adulu-bang/chipathon-2026-gf180mcu-padring/signoff_reports/metrics.csv

Metric | Value
design__lint_error__count | 0
design__lint_timing_construct__count | 0
design__lint_warning__count | 1
design__inferred_latch__count | 0
design__instance__count | 5316
design__instance__area | 257479
design__instance_unmapped__count | 0
synthesis__check_error__count | 0
design__max_slew_violation__count__corner:nom_tt_025C_5v00 | 0
design__max_fanout_violation__count__corner:nom_tt_025C_5v00 | 0
design__max_cap_violation__count__corner:nom_tt_025C_5v00 | 0
power__internal__total | 0.0000039727974581182934
power__switching__total | 0.000004177526534476783
power__leakage__total | 3.2316324904968496E-7
power__total | 0.000008473487469018437
clock__skew__worst_hold__corner:nom_tt_025C_5v00 | 0.0
clock__skew__worst_setup__corner:nom_tt_025C_5v00 | 0.0
timing__hold__ws__corner:nom_tt_025C_5v00 | 21.90605980838216
timing__setup__ws__corner:nom_tt_025C_5v00 | 55.73807884115806
timing__hold__tns__corner:nom_tt_025C_5v00 | 0.0
timing__setup__tns__corner:nom_tt_025C_5v00 | 0.0
timing__hold__wns__corner:nom_tt_025C_5v00 | 0
timing__setup__wns__corner:nom_tt_025C_5v00 | 0.0
timing__hold_vio__count__corner:nom_tt_025C_5v00 | 0
timing__hold_r2r__ws__corner:nom_tt_025C_5v00 | Infinity
timing__hold_r2r_vio__count__corner:nom_tt_025C_5v00 | 0
timing__setup_vio__count__corner:nom_tt_025C_5v00 | 0
timing__setup_r2r__ws__corner:nom_tt_025C_5v00 | Infinity
timing__setup_r2r_vio__count__corner:nom_tt_025C_5v00 | 0
design__max_slew_violation__count__corner:nom_ss_125C_4v50 | 0
design__max_fanout_violation__count__corner:nom_ss_125C_4v50 | 0
design__max_cap_violation__count__corner:nom_ss_125C_4v50 | 0
clock__skew__worst_hold__corner:nom_ss_125C_4v50 | 0.0
clock__skew__worst_setup__corner:nom_ss_125C_4v50 | 0.0
timing__hold__ws__corner:nom_ss_125C_4v50 | 23.881338471593665
timing__setup__ws__corner:nom_ss_125C_4v50 | 52.35916737267601
timing__hold__tns__corner:nom_ss_125C_4v50 | 0.0
timing__setup__tns__corner:nom_ss_125C_4v50 | 0.0
timing__hold__wns__corner:nom_ss_125C_4v50 | 0
timing__setup__wns__corner:nom_ss_125C_4v50 | 0.0
timing__hold_vio__count__corner:nom_ss_125C_4v50 | 0
timing__hold_r2r__ws__corner:nom_ss_125C_4v50 | Infinity
timing__hold_r2r_vio__count__corner:nom_ss_125C_4v50 | 0
timing__setup_vio__count__corner:nom_ss_125C_4v50 | 0
timing__setup_r2r__ws__corner:nom_ss_125C_4v50 | Infinity
timing__setup_r2r_vio__count__corner:nom_ss_125C_4v50 | 0
design__max_slew_violation__count__corner:nom_ff_n40C_5v50 | 0
design__max_fanout_violation__count__corner:nom_ff_n40C_5v50 | 0
design__max_cap_violation__count__corner:nom_ff_n40C_5v50 | 0
clock__skew__worst_hold__corner:nom_ff_n40C_5v50 | 0.0
clock__skew__worst_setup__corner:nom_ff_n40C_5v50 | 0.0
timing__hold__ws__corner:nom_ff_n40C_5v50 | 21.042181925812898
timing__setup__ws__corner:nom_ff_n40C_5v50 | 57.26129421588221
timing__hold__tns__corner:nom_ff_n40C_5v50 | 0.0
timing__setup__tns__corner:nom_ff_n40C_5v50 | 0.0
timing__hold__wns__corner:nom_ff_n40C_5v50 | 0
timing__setup__wns__corner:nom_ff_n40C_5v50 | 0.0
timing__hold_vio__count__corner:nom_ff_n40C_5v50 | 0
timing__hold_r2r__ws__corner:nom_ff_n40C_5v50 | Infinity
timing__hold_r2r_vio__count__corner:nom_ff_n40C_5v50 | 0
timing__setup_vio__count__corner:nom_ff_n40C_5v50 | 0
timing__setup_r2r__ws__corner:nom_ff_n40C_5v50 | Infinity
timing__setup_r2r_vio__count__corner:nom_ff_n40C_5v50 | 0
design__max_slew_violation__count__corner:min_tt_025C_5v00 | 0
design__max_fanout_violation__count__corner:min_tt_025C_5v00 | 0
design__max_cap_violation__count__corner:min_tt_025C_5v00 | 0
clock__skew__worst_hold__corner:min_tt_025C_5v00 | 0.0
clock__skew__worst_setup__corner:min_tt_025C_5v00 | 0.0
timing__hold__ws__corner:min_tt_025C_5v00 | 21.876268526986024
timing__setup__ws__corner:min_tt_025C_5v00 | 55.827550384975396
timing__hold__tns__corner:min_tt_025C_5v00 | 0.0
timing__setup__tns__corner:min_tt_025C_5v00 | 0.0
timing__hold__wns__corner:min_tt_025C_5v00 | 0
timing__setup__wns__corner:min_tt_025C_5v00 | 0.0
timing__hold_vio__count__corner:min_tt_025C_5v00 | 0
timing__hold_r2r__ws__corner:min_tt_025C_5v00 | Infinity
timing__hold_r2r_vio__count__corner:min_tt_025C_5v00 | 0
timing__setup_vio__count__corner:min_tt_025C_5v00 | 0
timing__setup_r2r__ws__corner:min_tt_025C_5v00 | Infinity
timing__setup_r2r_vio__count__corner:min_tt_025C_5v00 | 0
design__max_slew_violation__count__corner:min_ss_125C_4v50 | 0
design__max_fanout_violation__count__corner:min_ss_125C_4v50 | 0
design__max_cap_violation__count__corner:min_ss_125C_4v50 | 0
clock__skew__worst_hold__corner:min_ss_125C_4v50 | 0.0
clock__skew__worst_setup__corner:min_ss_125C_4v50 | 0.0
timing__hold__ws__corner:min_ss_125C_4v50 | 23.83451548033967
timing__setup__ws__corner:min_ss_125C_4v50 | 52.508605172373784
timing__hold__tns__corner:min_ss_125C_4v50 | 0.0
timing__setup__tns__corner:min_ss_125C_4v50 | 0.0
timing__hold__wns__corner:min_ss_125C_4v50 | 0
timing__setup__wns__corner:min_ss_125C_4v50 | 0.0
timing__hold_vio__count__corner:min_ss_125C_4v50 | 0
timing__hold_r2r__ws__corner:min_ss_125C_4v50 | Infinity
timing__hold_r2r_vio__count__corner:min_ss_125C_4v50 | 0
timing__setup_vio__count__corner:min_ss_125C_4v50 | 0
timing__setup_r2r__ws__corner:min_ss_125C_4v50 | Infinity
timing__setup_r2r_vio__count__corner:min_ss_125C_4v50 | 0
design__max_slew_violation__count__corner:min_ff_n40C_5v50 | 0
design__max_fanout_violation__count__corner:min_ff_n40C_5v50 | 0
design__max_cap_violation__count__corner:min_ff_n40C_5v50 | 0
clock__skew__worst_hold__corner:min_ff_n40C_5v50 | 0.0
clock__skew__worst_setup__corner:min_ff_n40C_5v50 | 0.0
timing__hold__ws__corner:min_ff_n40C_5v50 | 21.021073476893317
timing__setup__ws__corner:min_ff_n40C_5v50 | 57.320791513543774
timing__hold__tns__corner:min_ff_n40C_5v50 | 0.0
timing__setup__tns__corner:min_ff_n40C_5v50 | 0.0
timing__hold__wns__corner:min_ff_n40C_5v50 | 0
timing__setup__wns__corner:min_ff_n40C_5v50 | 0.0
timing__hold_vio__count__corner:min_ff_n40C_5v50 | 0
timing__hold_r2r__ws__corner:min_ff_n40C_5v50 | Infinity
timing__hold_r2r_vio__count__corner:min_ff_n40C_5v50 | 0
timing__setup_vio__count__corner:min_ff_n40C_5v50 | 0
timing__setup_r2r__ws__corner:min_ff_n40C_5v50 | Infinity
timing__setup_r2r_vio__count__corner:min_ff_n40C_5v50 | 0
design__max_slew_violation__count__corner:max_tt_025C_5v00 | 0
design__max_fanout_violation__count__corner:max_tt_025C_5v00 | 0
design__max_cap_violation__count__corner:max_tt_025C_5v00 | 0
clock__skew__worst_hold__corner:max_tt_025C_5v00 | 0.0
clock__skew__worst_setup__corner:max_tt_025C_5v00 | 0.0
timing__hold__ws__corner:max_tt_025C_5v00 | 21.939949145122696
timing__setup__ws__corner:max_tt_025C_5v00 | 55.63240692250721
timing__hold__tns__corner:max_tt_025C_5v00 | 0.0
timing__setup__tns__corner:max_tt_025C_5v00 | 0.0
timing__hold__wns__corner:max_tt_025C_5v00 | 0
timing__setup__wns__corner:max_tt_025C_5v00 | 0.0
timing__hold_vio__count__corner:max_tt_025C_5v00 | 0
timing__hold_r2r__ws__corner:max_tt_025C_5v00 | Infinity
timing__hold_r2r_vio__count__corner:max_tt_025C_5v00 | 0
timing__setup_vio__count__corner:max_tt_025C_5v00 | 0
timing__setup_r2r__ws__corner:max_tt_025C_5v00 | Infinity
timing__setup_r2r_vio__count__corner:max_tt_025C_5v00 | 0
design__max_slew_violation__count__corner:max_ss_125C_4v50 | 0
design__max_fanout_violation__count__corner:max_ss_125C_4v50 | 0
design__max_cap_violation__count__corner:max_ss_125C_4v50 | 0
clock__skew__worst_hold__corner:max_ss_125C_4v50 | 0.0
clock__skew__worst_setup__corner:max_ss_125C_4v50 | 0.0
timing__hold__ws__corner:max_ss_125C_4v50 | 23.935876180819363
timing__setup__ws__corner:max_ss_125C_4v50 | 52.182657893980135
timing__hold__tns__corner:max_ss_125C_4v50 | 0.0
timing__setup__tns__corner:max_ss_125C_4v50 | 0.0
timing__hold__wns__corner:max_ss_125C_4v50 | 0
timing__setup__wns__corner:max_ss_125C_4v50 | 0.0
timing__hold_vio__count__corner:max_ss_125C_4v50 | 0
timing__hold_r2r__ws__corner:max_ss_125C_4v50 | Infinity
timing__hold_r2r_vio__count__corner:max_ss_125C_4v50 | 0
timing__setup_vio__count__corner:max_ss_125C_4v50 | 0
timing__setup_r2r__ws__corner:max_ss_125C_4v50 | Infinity
timing__setup_r2r_vio__count__corner:max_ss_125C_4v50 | 0
design__max_slew_violation__count__corner:max_ff_n40C_5v50 | 0
design__max_fanout_violation__count__corner:max_ff_n40C_5v50 | 0
design__max_cap_violation__count__corner:max_ff_n40C_5v50 | 0
clock__skew__worst_hold__corner:max_ff_n40C_5v50 | 0.0
clock__skew__worst_setup__corner:max_ff_n40C_5v50 | 0.0
timing__hold__ws__corner:max_ff_n40C_5v50 | 21.06574352359707
timing__setup__ws__corner:max_ff_n40C_5v50 | 57.19047797211986
timing__hold__tns__corner:max_ff_n40C_5v50 | 0.0
timing__setup__tns__corner:max_ff_n40C_5v50 | 0.0
timing__hold__wns__corner:max_ff_n40C_5v50 | 0
timing__setup__wns__corner:max_ff_n40C_5v50 | 0.0
timing__hold_vio__count__corner:max_ff_n40C_5v50 | 0
timing__hold_r2r__ws__corner:max_ff_n40C_5v50 | Infinity
timing__hold_r2r_vio__count__corner:max_ff_n40C_5v50 | 0
timing__setup_vio__count__corner:max_ff_n40C_5v50 | 0
timing__setup_r2r__ws__corner:max_ff_n40C_5v50 | Infinity
timing__setup_r2r_vio__count__corner:max_ff_n40C_5v50 | 0
design__max_slew_violation__count | 0
design__max_fanout_violation__count | 0
design__max_cap_violation__count | 0
clock__skew__worst_hold | 0.0
clock__skew__worst_setup | 0.0
timing__hold__ws | 21.021073476893317
timing__setup__ws | 52.182657893980135
timing__hold__tns | 0.0
timing__setup__tns | 0.0
timing__hold__wns | 0
timing__setup__wns | 0.0
timing__hold_vio__count | 0
timing__hold_r2r__ws | inf
timing__hold_r2r_vio__count | 0
timing__setup_vio__count | 0
timing__setup_r2r__ws | inf
timing__setup_r2r_vio__count | 0
design__die__bbox | 0.0 0.0 550.0 550.0
design__core__bbox | 15.12 15.68 534.8 533.12
design__io | 36
design__die__area | 302500
design__core__area | 268903
design__instance__count__stdcell | 1870
design__instance__area__stdcell | 8594.21
design__instance__count__macros | 2
design__instance__area__macros | 32600.9
design__instance__count__padcells | 0
design__instance__area__padcells | 0
design__instance__count__cover | 0
design__instance__area__cover | 0
design__instance__utilization | 0.153197
design__instance__utilization__stdcell | 0.0363695
design__rows | 179
design__rows:GF018hv5v_mcu_sc7 | 179
design__sites | 102441
design__sites:GF018hv5v_mcu_sc7 | 102441
design__instance__count__class:macro | 2
design__instance__area__class:macro | 32600.9
design__instance__count__class:tie_cell | 24
design__instance__area__class:tie_cell | 210.739
design__instance__count__class:multi_input_combinational_cell | 3
design__instance__area__class:multi_input_combinational_cell | 76.832
flow__warnings__count | 1
flow__errors__count | 0
flow__warnings__count:IFP-0028 | 1
flow__warnings__count:ODB-0220 | 3
flow__warnings__count:ORD-2011 | 1
flow__warnings__type_count | 1
flow__warnings__count:ORD-0039 | 1
design__instance__count__class:endcap_cell | 358
design__instance__area__class:endcap_cell | 1571.76
design__instance__count__class:tap_cell | 1458
design__instance__area__class:tap_cell | 6401.2
design__power_grid_violation__count__net:GND | 0
design__power_grid_violation__count__net:VDD | 0
design__power_grid_violation__count | 0
timing__drv__floating__nets | 2
timing__drv__floating__pins | 0
design__instance__displacement__total | 0
design__instance__displacement__mean | 0
design__instance__displacement__max | 0
route__wirelength__estimated | 5074.58
design__violations | 0
design__instance__count__class:timing_repair_buffer | 7
design__instance__area__class:timing_repair_buffer | 245.862
flow__warnings__count:RSZ-0020 | 1
flow__warnings__count:STA-1140 | 14
flow__warnings__count:CTS-0041 | 1
flow__warnings__count:CTS-0082 | 1
flow__warnings__count:CTS-0083 | 1
design__instance__count__setup_buffer | 0
design__instance__count__hold_buffer | 0
global_route__vias | 206
global_route__wirelength | 5636
antenna__violating__nets | 0
antenna__violating__pins | 0
route__antenna_violation__count | 0
design__instance__count__class:antenna_cell | 20
design__instance__area__class:antenna_cell | 87.808
antenna_diodes_count | 0
route__net | 46
route__net__special | 2
route__drc_errors__iter:0 | 0
route__wirelength__iter:0 | 5051
route__drc_errors | 0
route__wirelength | 5051
route__vias | 159
route__vias__singlecut | 159
route__vias__multicut | 0
flow__warnings__count:DRT-0349 | 8
design__disconnected_pin__count | 0
design__critical_disconnected_pin__count | 0
route__wirelength__max | 766.46
design__instance__count__class:fill_cell | 3444
design__instance__area__class:fill_cell | 216284
timing__unannotated_net__count__corner:nom_tt_025C_5v00 | 2
timing__unannotated_net_filtered__count__corner:nom_tt_025C_5v00 | 0
timing__unannotated_net__count__corner:nom_ss_125C_4v50 | 2
timing__unannotated_net_filtered__count__corner:nom_ss_125C_4v50 | 0
timing__unannotated_net__count__corner:nom_ff_n40C_5v50 | 2
timing__unannotated_net_filtered__count__corner:nom_ff_n40C_5v50 | 0
timing__unannotated_net__count__corner:min_tt_025C_5v00 | 2
timing__unannotated_net_filtered__count__corner:min_tt_025C_5v00 | 0
timing__unannotated_net__count__corner:min_ss_125C_4v50 | 2
timing__unannotated_net_filtered__count__corner:min_ss_125C_4v50 | 0
timing__unannotated_net__count__corner:min_ff_n40C_5v50 | 2
timing__unannotated_net_filtered__count__corner:min_ff_n40C_5v50 | 0
timing__unannotated_net__count__corner:max_tt_025C_5v00 | 2
timing__unannotated_net_filtered__count__corner:max_tt_025C_5v00 | 0
timing__unannotated_net__count__corner:max_ss_125C_4v50 | 2
timing__unannotated_net_filtered__count__corner:max_ss_125C_4v50 | 0
timing__unannotated_net__count__corner:max_ff_n40C_5v50 | 2
timing__unannotated_net_filtered__count__corner:max_ff_n40C_5v50 | 0
timing__unannotated_net__count | 2
timing__unannotated_net_filtered__count | 0
design__xor_difference__count | 0
magic__drc_error__count | 0
klayout__drc_error__count | 0
magic__illegal_overlap__count | 0
design__lvs_device_difference__count | 0
design__lvs_net_difference__count | 0
design__lvs_property_fail__count | 0
design__lvs_error__count | 0
design__lvs_unmatched_device__count | 0
design__lvs_unmatched_net__count | 0
design__lvs_unmatched_pin__count | 0
