adulu-bang/chipathon-2026-gf180mcu-padring/verilog/analog_stub.v

(* blackbox *)
module ring_oscillator_final (
  `ifdef USE_POWER_PINS
    inout wire VDD,
    inout wire GND,
`endif
    input wire VinVCO,
    output wire VO
);
//dummy module for the analog macro
endmodule
