adulu-bang/chipathon-2026-gf180mcu-padring/src/sync_2ff.v

module sync_2ff (
    input  wire clk,
    input  wire rst_n,
    input  wire async_in,
    output wire sync_out
);

    reg ff1;
    reg ff2;

    always @(posedge clk or negedge rst_n) begin
        if (!rst_n) begin
            ff1 <= 1'b0;
            ff2 <= 1'b0;
        end
        else begin
            ff1 <= async_in;
            ff2 <= ff1;
        end
    end

    assign sync_out = ff2;

endmodule
