adulu-bang/chipathon-2026-gf180mcu-padring/(commit log)

2026-07-08 Add UART
2026-07-16 Add synchronous 2 flip-flop module
    [sync_2ff.v]
2026-07-23 Add analog src
    [biasing.sch, biasing_tb.sch, inv_starved.sch, inv_starved_tb.sch, xor_tb.sch]
2026-09-01 Add metrics.csv
    [metrics.csv]
2026-09-30 Update metrics
    [metrics.csv]
